alexjin520/lab-notebook-ece445-group10/notebooks/images/system_block_diagram.png

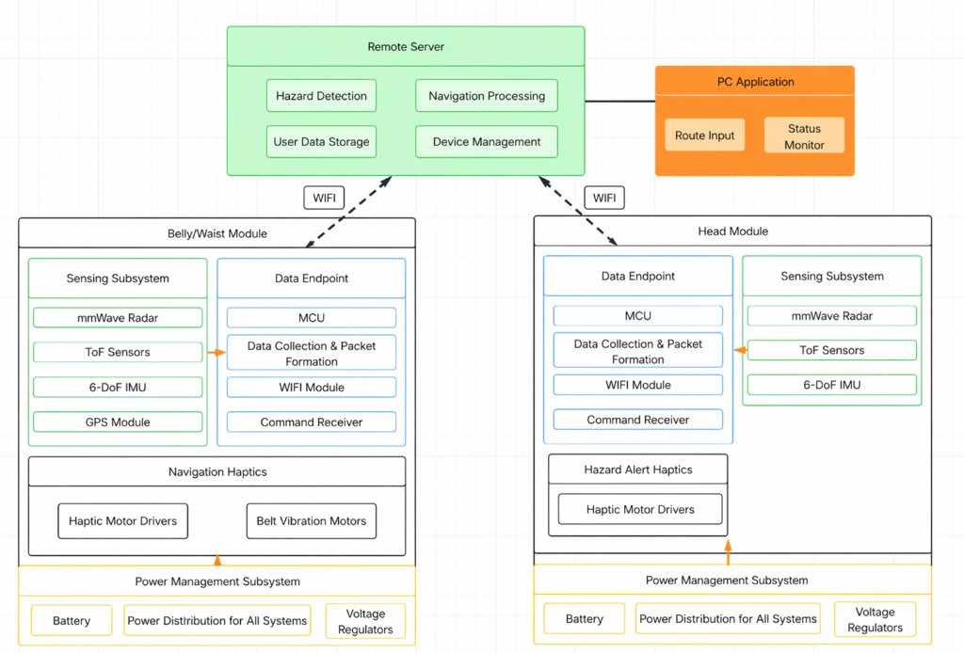
notebooks/images/system_block_diagram.png
