alexjin520/lab-notebook-ece445-group10/notebooks/images/system_concept.png

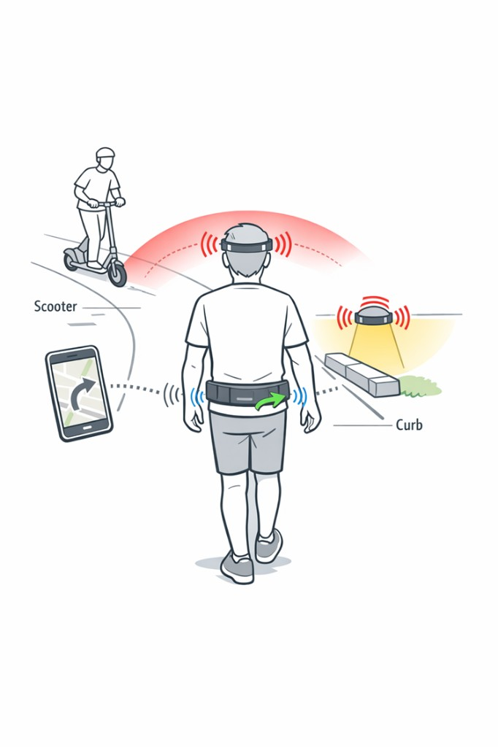
notebooks/images/system_concept.png
