alexjin520/lab-notebook-ece445-group10/(commit log)

2026-04-15 Update sketch with power system test code
    Made-with: Cursor
2026-04-26 Update codes for head module and include IMU codes
